G3WKW/G4JNUTester/README.md

# G4JNUTester
Simple tester for short circuit checking without damaging sensitive components.
