G3WKW/G4JNUTester/(list of files, drawings)

Other design files:
test/test.dsn
