G3WKW/G4JNUTester/test/test.kicad_pcb

## KiCad design test/test.kicad_pcb (2019-02-11)

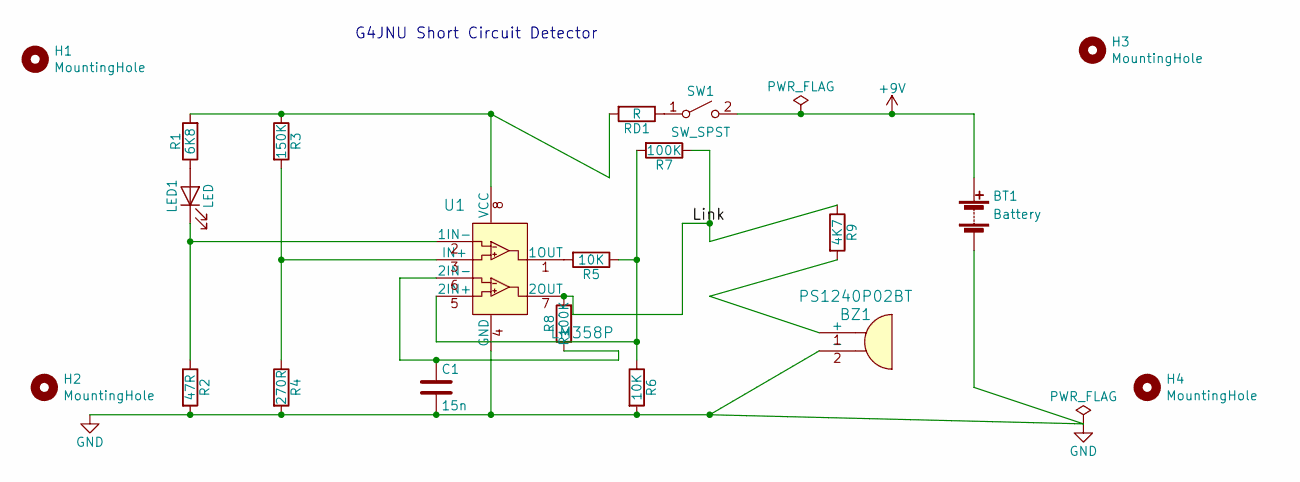
[picture p1: schematic test.sch]

Parts:
BT1: Battery; Pin_Header_Angled_1x02_Pitch2.54mm
BZ1: PS1240P02BT; Piezo_Transducer_THT_PS1240P02BT; MPN PS1240P02BT; Digi-Key_PN 445-2525-1-ND
C1: 15n; C_Axial_L3.8mm_D2.6mm_P10.00mm_Horizontal
H1, H2, H3, H4: MountingHole; MountingHole_2.2mm_M2
LED1: LED; LED_D1.8mm_W1.8mm_H2.4mm_Horizontal_O1.27mm_Z1.6mm
R1: 6K8; R_Axial_DIN0204_L3.6mm_D1.6mm_P5.08mm_Horizontal
R2: 47R; R_Axial_DIN0204_L3.6mm_D1.6mm_P5.08mm_Horizontal
R3: 150K; R_Axial_DIN0204_L3.6mm_D1.6mm_P5.08mm_Horizontal
R4: 270R; R_Axial_DIN0204_L3.6mm_D1.6mm_P5.08mm_Horizontal
R5, R6: 10K; R_Axial_DIN0204_L3.6mm_D1.6mm_P5.08mm_Horizontal
R7: 100K; R_Axial_DIN0204_L3.6mm_D1.6mm_P5.08mm_Horizontal
R8: R100K; R_Axial_DIN0204_L3.6mm_D1.6mm_P5.08mm_Horizontal
R9: 4K7; R_Axial_DIN0204_L3.6mm_D1.6mm_P5.08mm_Horizontal
RD1: R; D_5KPW_P12.70mm_Horizontal
SW1: SW_SPST; Switch
U1: LM358P; DIP-8_W7.62mm; MPN LM358P; Digi-Key_PN 296-1395-5-ND

Connections:
+9V: BT1.1 (+), SW1.2 (B)
/Link: R7.1, R8.2, R9.1, U1.7 (2OUT)
GND: BT1.2 (-), BZ1.2 (-), C1.2, R2.2, R4.2, R6.2, U1.4 (GND)
unnamed: BZ1.1 (+), R9.2
unnamed: C1.1, R8.1, U1.6 (2IN-)
unnamed: LED1.1 (K), R2.1, U1.2 (1IN-)
unnamed: LED1.2 (A), R1.1
unnamed: R1.2, R3.1, RD1.2, U1.8 (VCC)
unnamed: R3.2, R4.1, U1.3 (IN+)
unnamed: R5.1, R6.1, R7.2, U1.5 (2IN+)
unnamed: R5.2, U1.1 (1OUT)
unnamed: RD1.1, SW1.1 (A)

Notes on the sheet:
G4JNU Short Circuit Detector

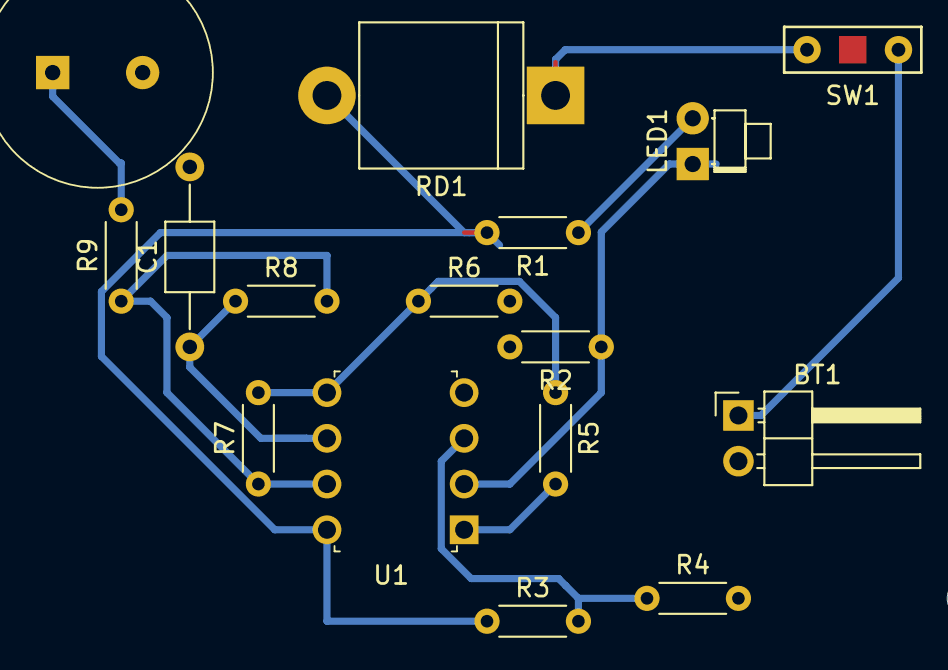
[picture p2: board test.kicad_pcb from above]

Board: 2 copper layers, 20 parts (0 on the bottom side), 12 nets.
