G3WKW/G4JNUTester/ContinuetyTesterFinal - Schematic.jpg

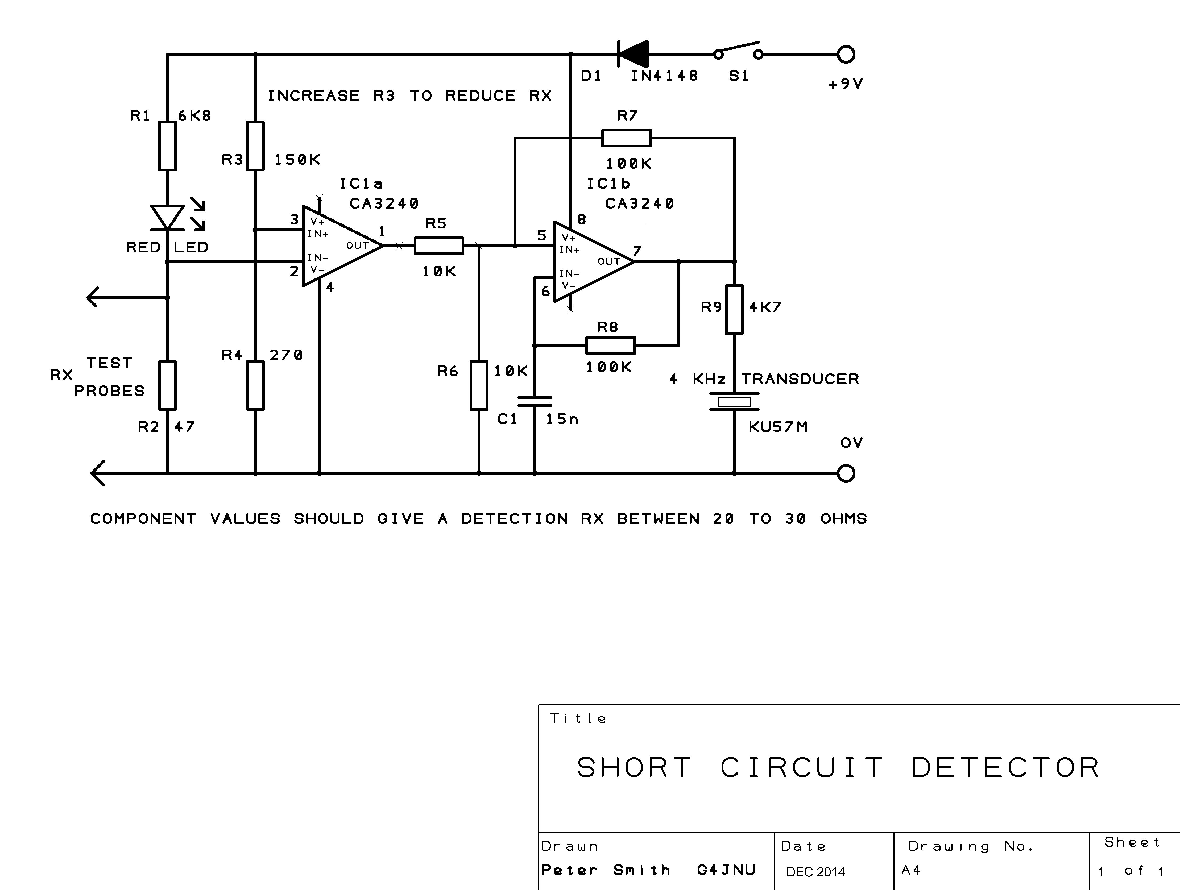
ContinuetyTesterFinal - Schematic.jpg
