G3WKW/G4JNUTester/(commit log)

2018-09-28 Updated during construction evening
    [test-B.Cu.gbl, test-B.Cu.gbr, test-B.SilkS.gbo, test-B.SilkS.gbr, test-F.Cu.gbr, test-F.Cu.gtl, test-F.SilkS.gbr, test-F.SilkS.gto]
2018-09-28 Trying out 5.0
    [test.kicad_pcb, test.sch]
2019-02-11 Updated 7/2/20119 during meeting at RRFC
    [test.kicad_pcb, test.sch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]
